fBlurryface/Atmega328p-max30102-pulse-monitor/images/bootloader-reverse-side.jpg

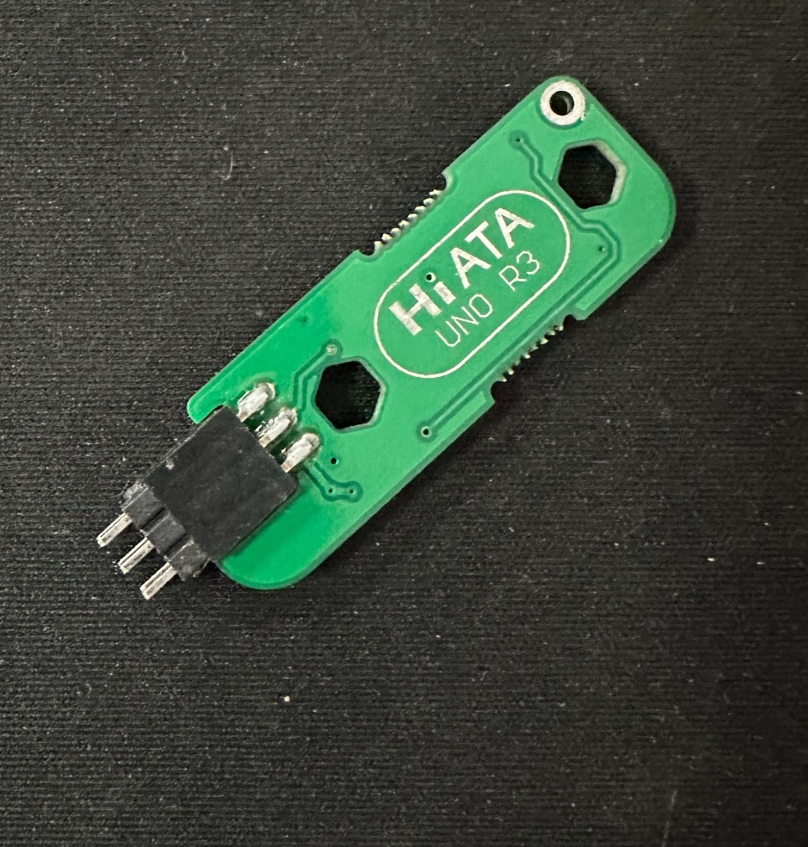
images/bootloader-reverse-side.jpg
