fBlurryface/Atmega328p-max30102-pulse-monitor/images/bootloader-component-side.jpg

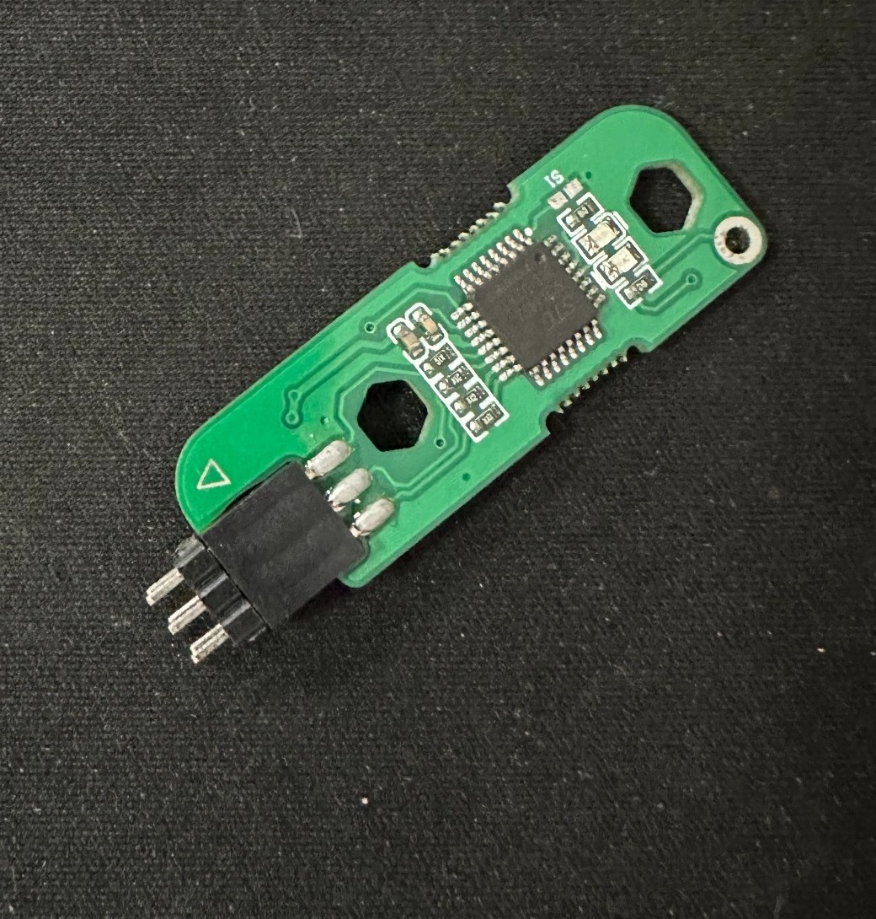
images/bootloader-component-side.jpg
