fBlurryface/Atmega328p-max30102-pulse-monitor/hardware/pcb/pcb-layout.pdf

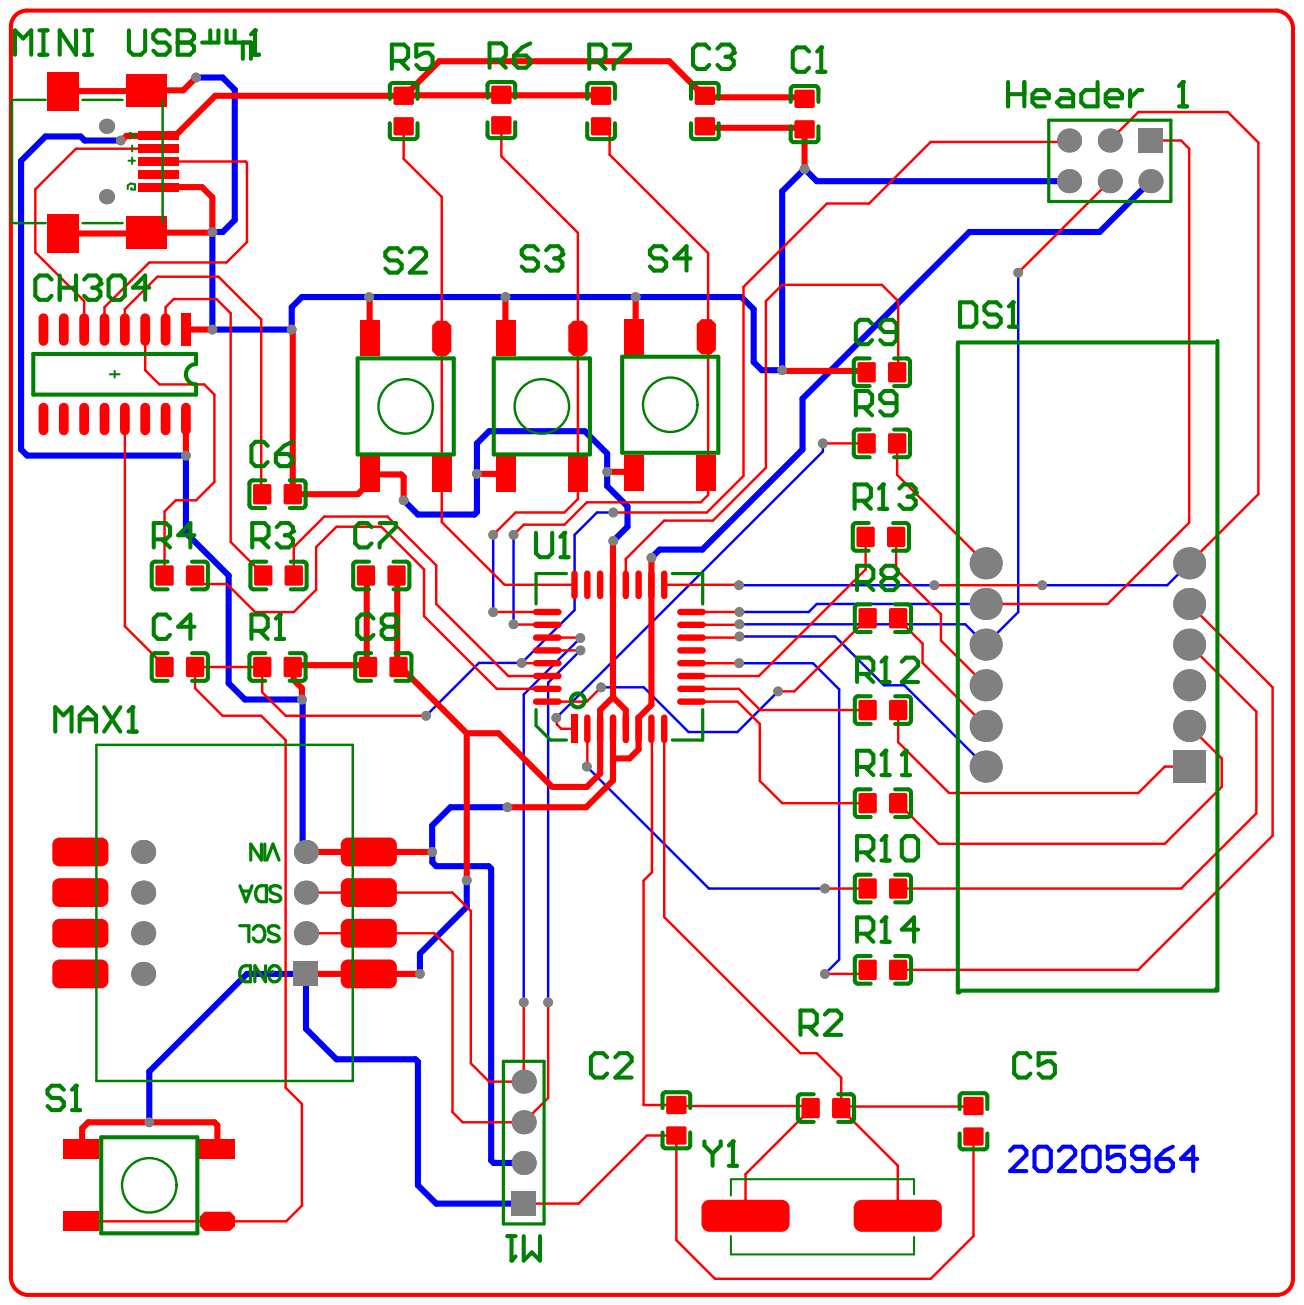
[picture p11: page 1]
