fBlurryface/Atmega328p-max30102-pulse-monitor/hardware/schematic/schematic.pdf

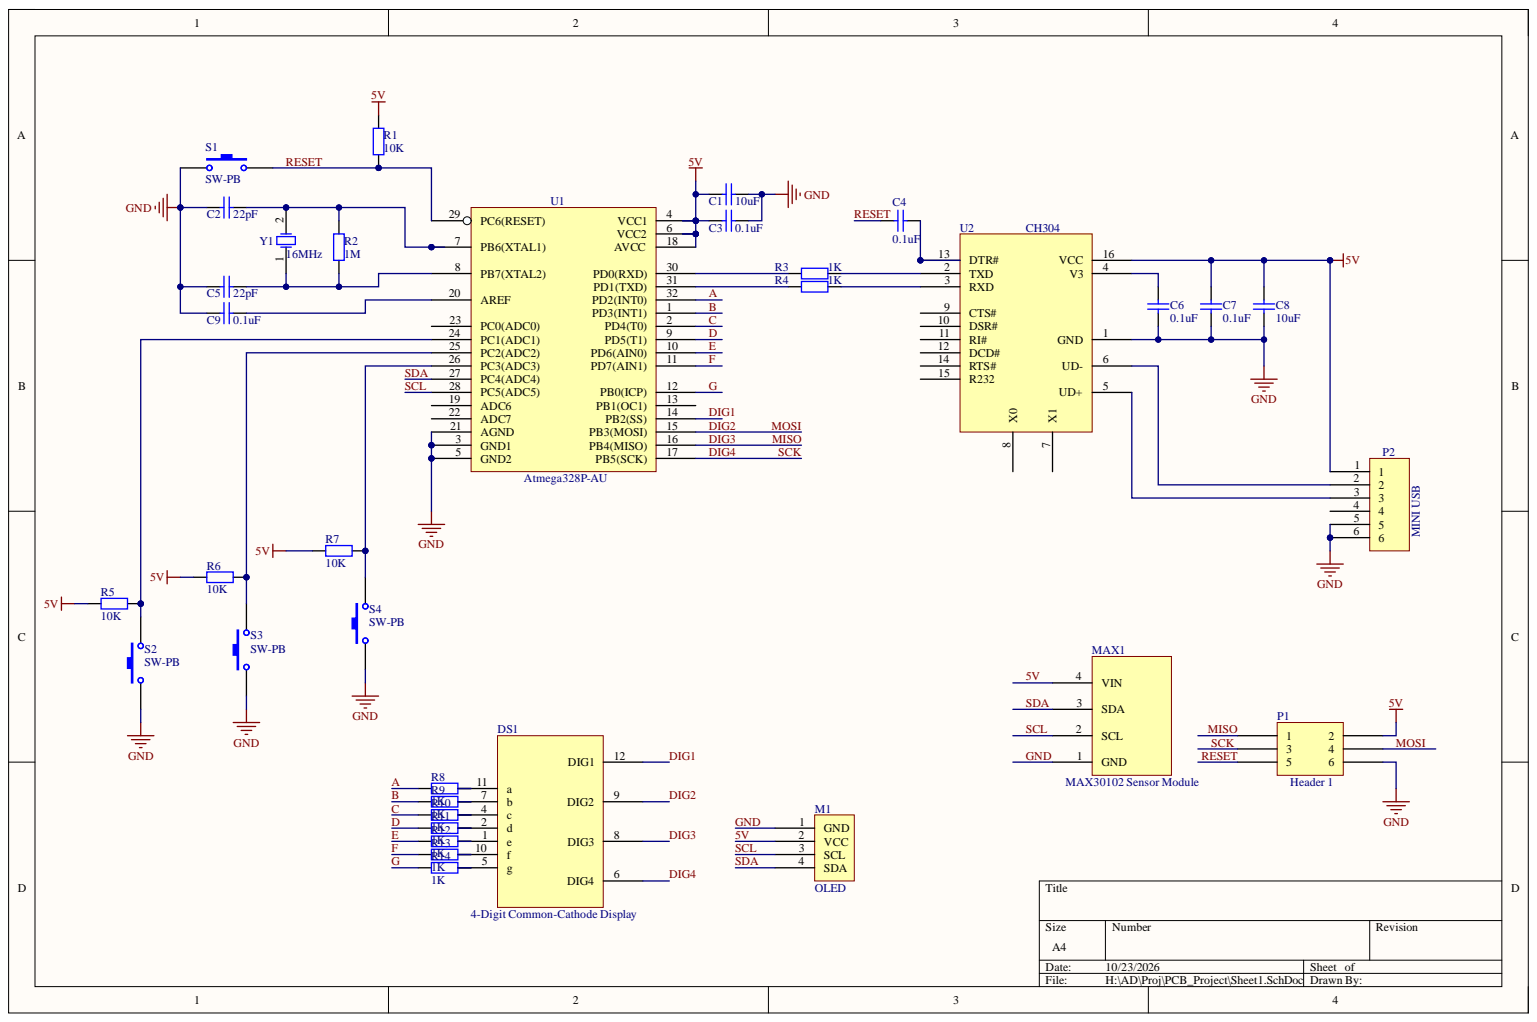
[picture p12: page 1]

p F | | 3 2 9 1 2 MOSI

2 2 | 1 4
2 1 | 1 5 DIG
3 | 1 6 DIG 3 MISO
5 | 1 7 DIG 4 SCK
