fBlurryface/Atmega328p-max30102-pulse-monitor/(list of files, drawings)

Other design files:
hardware/pcb/PCB1.PcbDoc
hardware/pcb/PcbLib1.PcbLib
hardware/PCB_Project.PrjPcb
hardware/schematic/PCB_Project.SCHLIB
hardware/schematic/Sheet1.SchDoc
